Trishan0/cocktail-crafter/frontend/src/assets/backdrops/machine-bg.webp

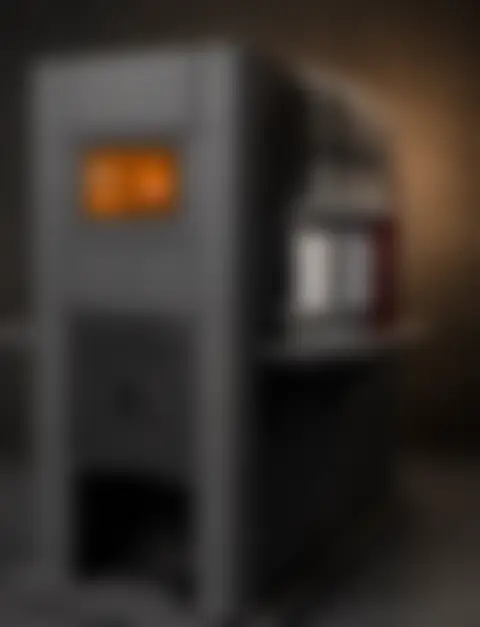
frontend/src/assets/backdrops/machine-bg.webp
