Trishan0/cocktail-crafter/frontend/src/assets/backdrops/machine.webp

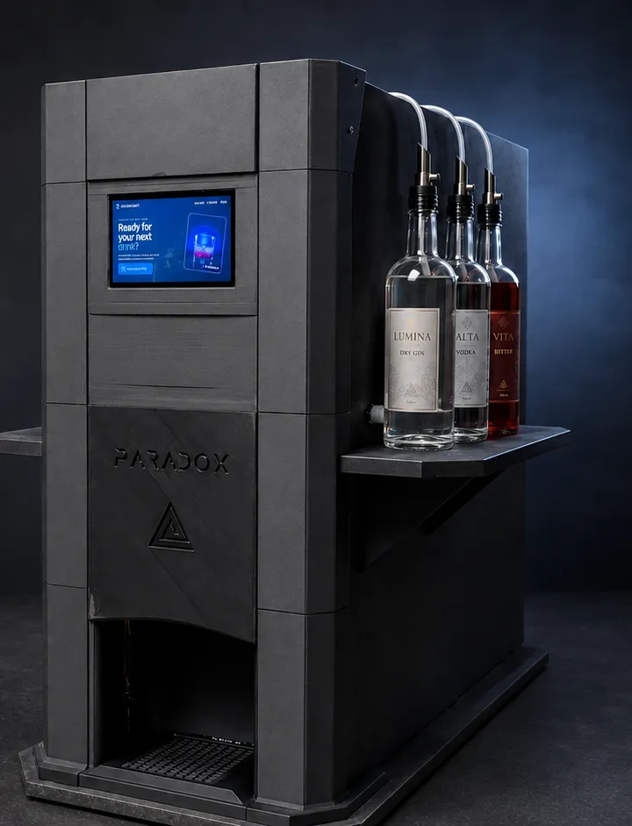
frontend/src/assets/backdrops/machine.webp
