Trishan0/cocktail-crafter/frontend/src/assets/Citriuz rose sprite.png

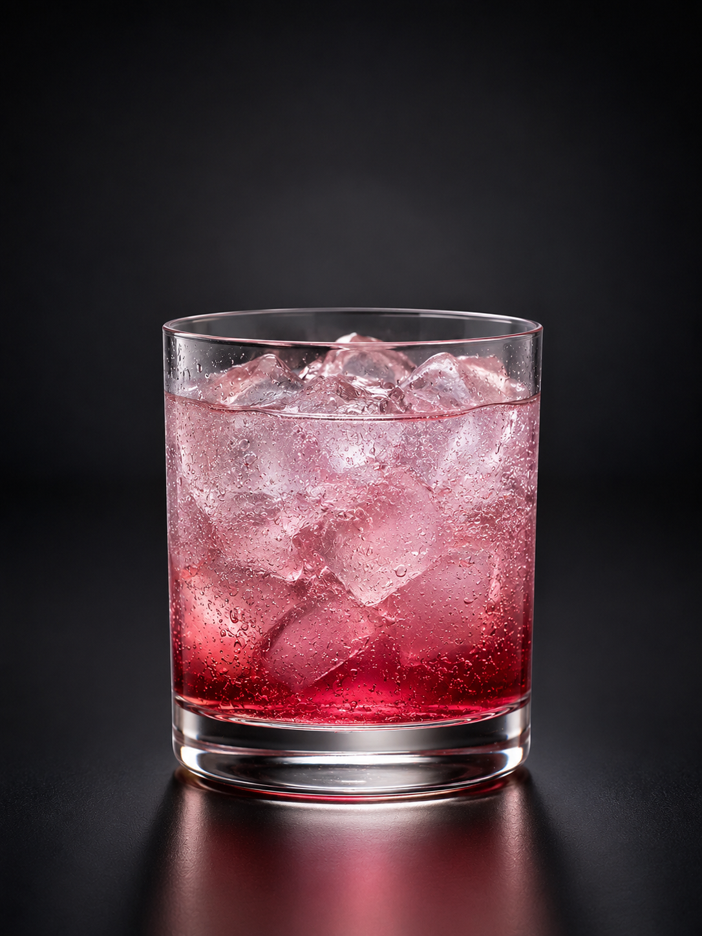
frontend/src/assets/Citriuz rose sprite.png
