Trishan0/cocktail-crafter/frontend/src/assets/cocktail-1.jpg

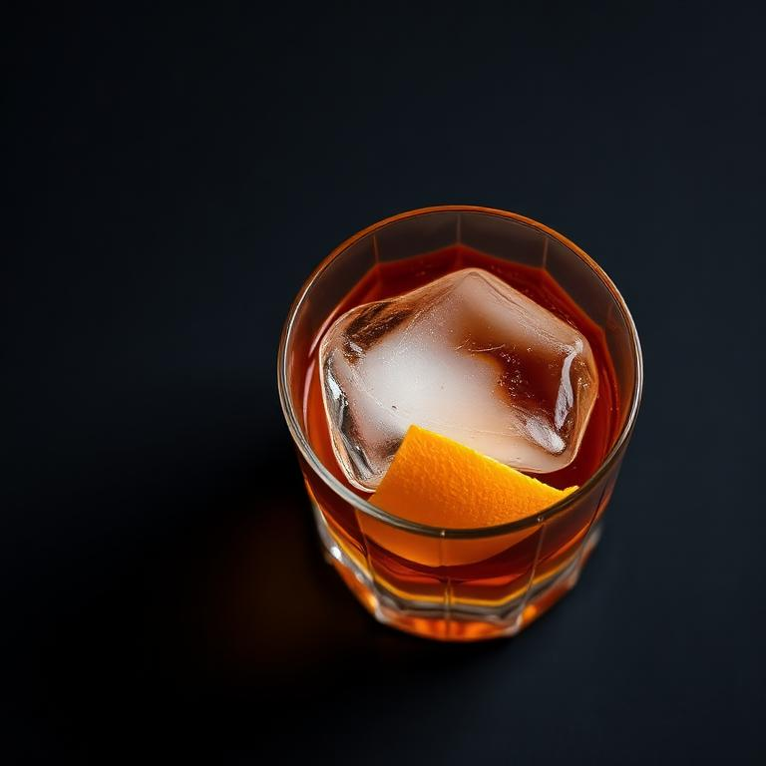
frontend/src/assets/cocktail-1.jpg
