Trishan0/cocktail-crafter/frontend/src/assets/cocktail-2.jpg

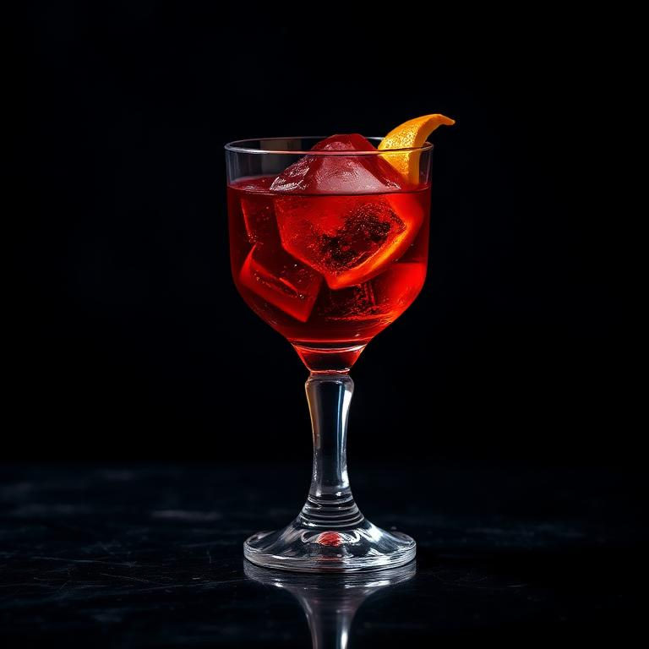
frontend/src/assets/cocktail-2.jpg
