Trishan0/cocktail-crafter/frontend/src/assets/cocktail-3.jpg

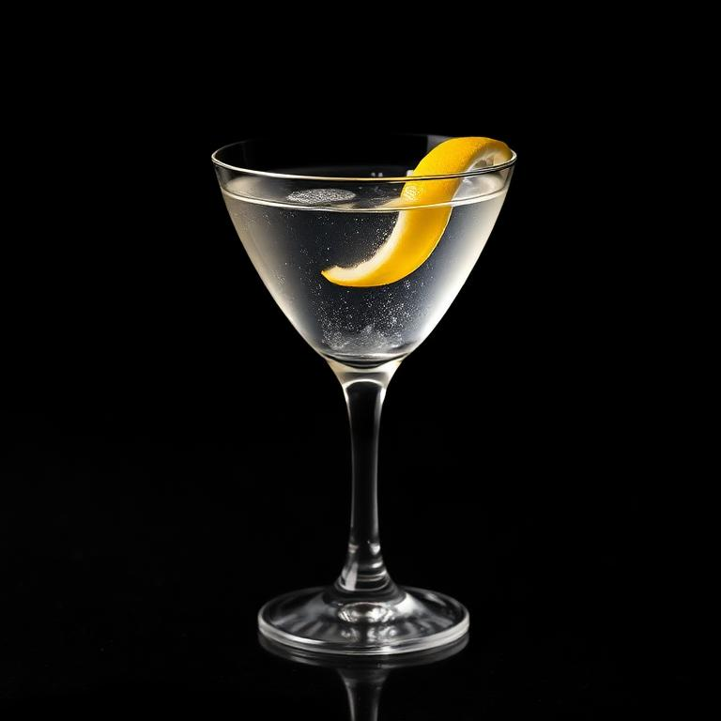
frontend/src/assets/cocktail-3.jpg
