Trishan0/cocktail-crafter/frontend/src/assets/cocktail-4.jpg

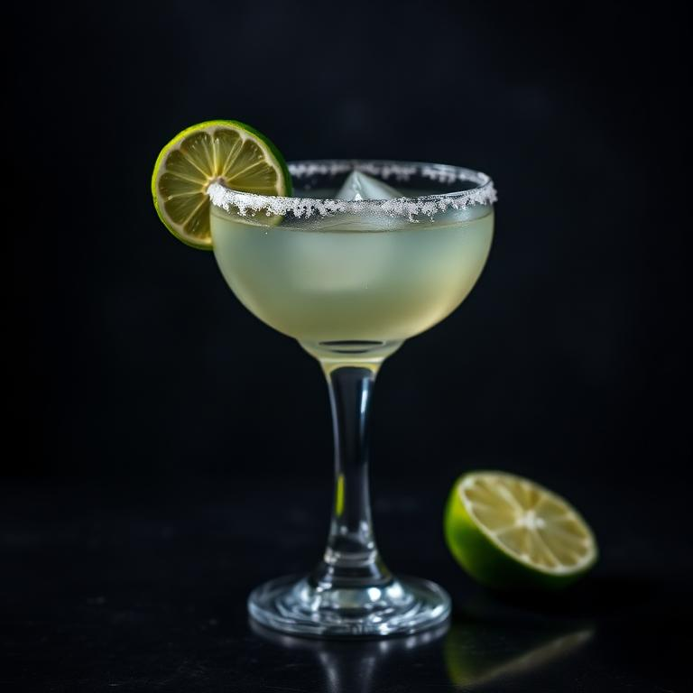
frontend/src/assets/cocktail-4.jpg
