Trishan0/cocktail-crafter/frontend/src/assets/cocktail-5.jpg

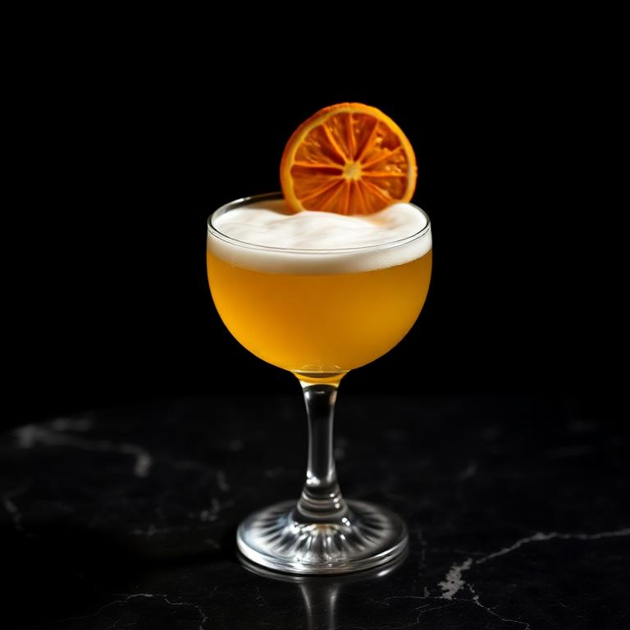
frontend/src/assets/cocktail-5.jpg
