Trishan0/cocktail-crafter/frontend/src/assets/cocktail-6.jpg

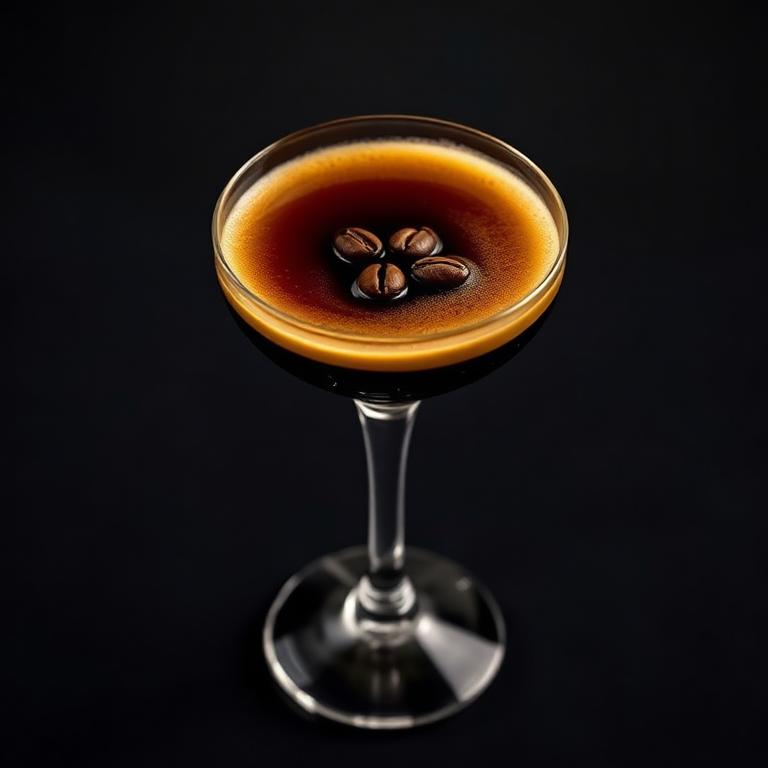
frontend/src/assets/cocktail-6.jpg
