Trishan0/cocktail-crafter/frontend/src/assets/cocktail-ready.png

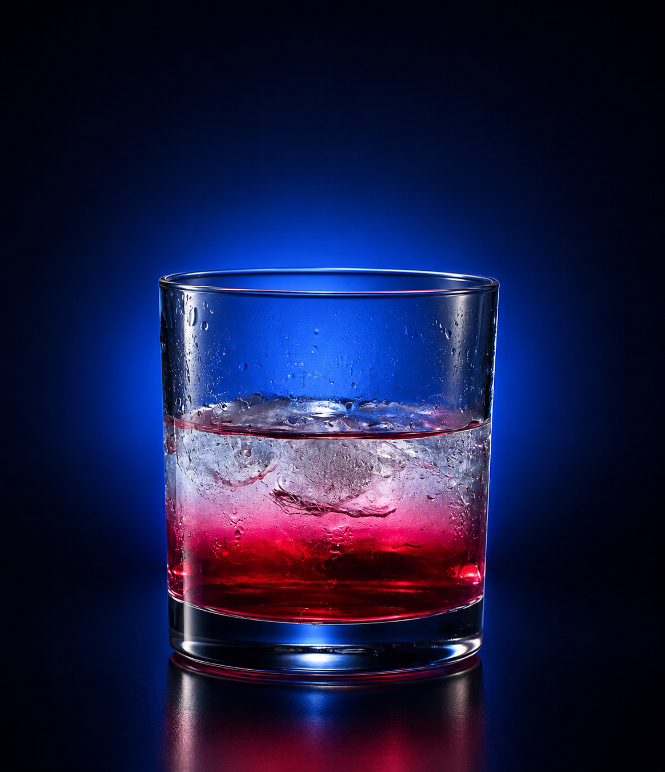
frontend/src/assets/cocktail-ready.png
