Trishan0/cocktail-crafter/frontend/src/assets/custom-drink.png

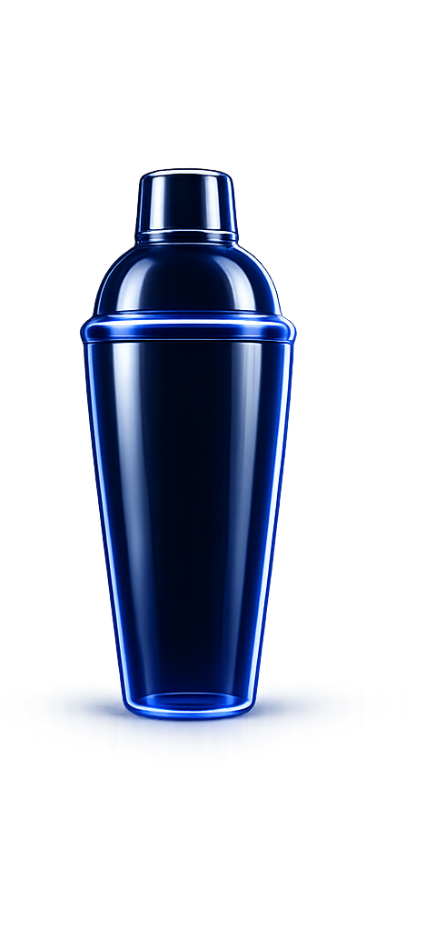
frontend/src/assets/custom-drink.png
