Trishan0/cocktail-crafter/frontend/src/assets/default-drink.png

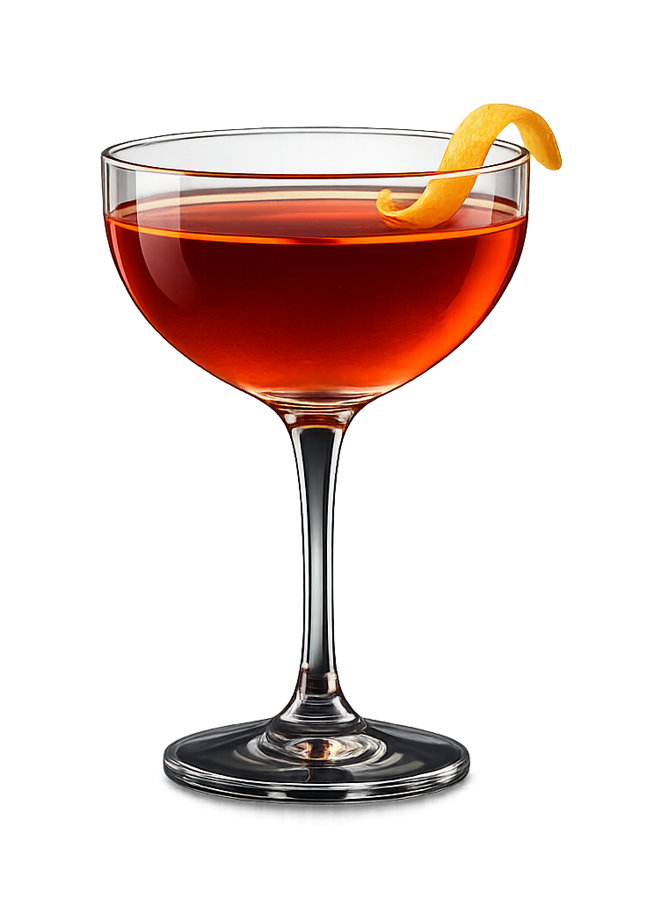
frontend/src/assets/default-drink.png
