Trishan0/cocktail-crafter/frontend/src/assets/drinks/apple-rose-fizz-bg.webp

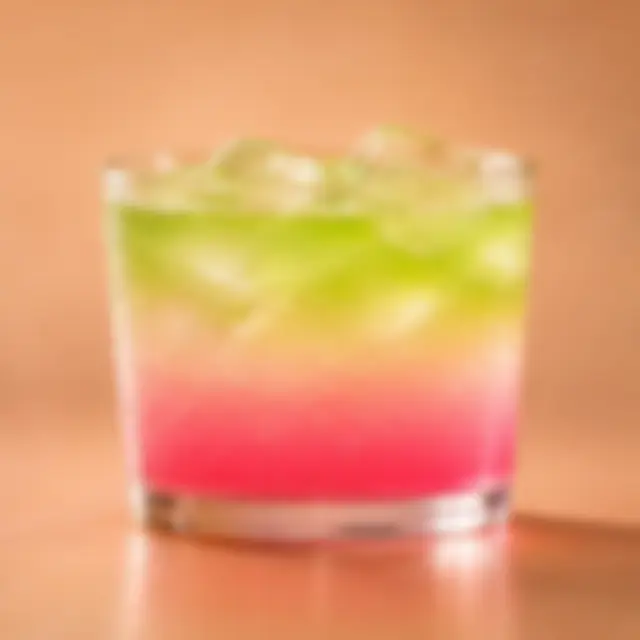
frontend/src/assets/drinks/apple-rose-fizz-bg.webp
