Trishan0/cocktail-crafter/frontend/src/assets/drinks/citrus-sunrise-bg.webp

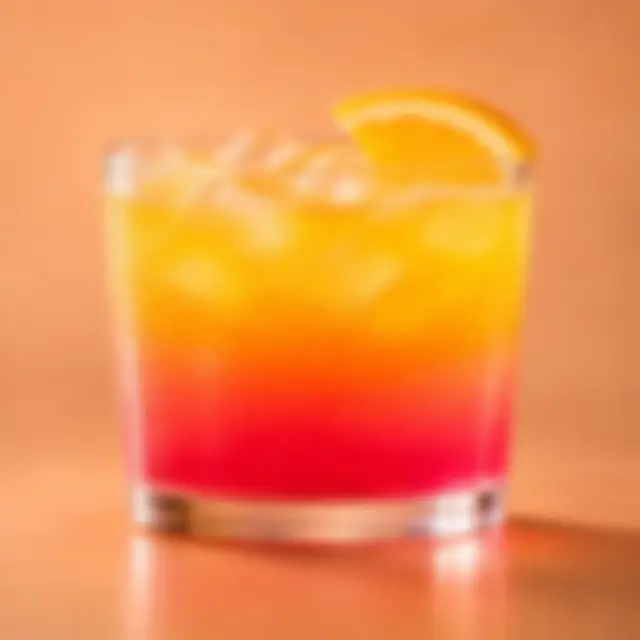
frontend/src/assets/drinks/citrus-sunrise-bg.webp
