Trishan0/cocktail-crafter/frontend/src/assets/drinks/golden-apple-twist-bg.webp

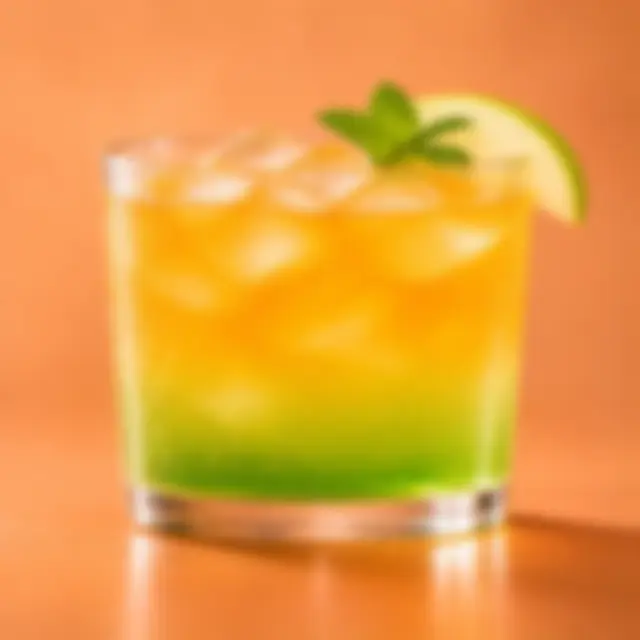
frontend/src/assets/drinks/golden-apple-twist-bg.webp
