Trishan0/cocktail-crafter/frontend/src/assets/drinks/green-apple-sparkle-bg.webp

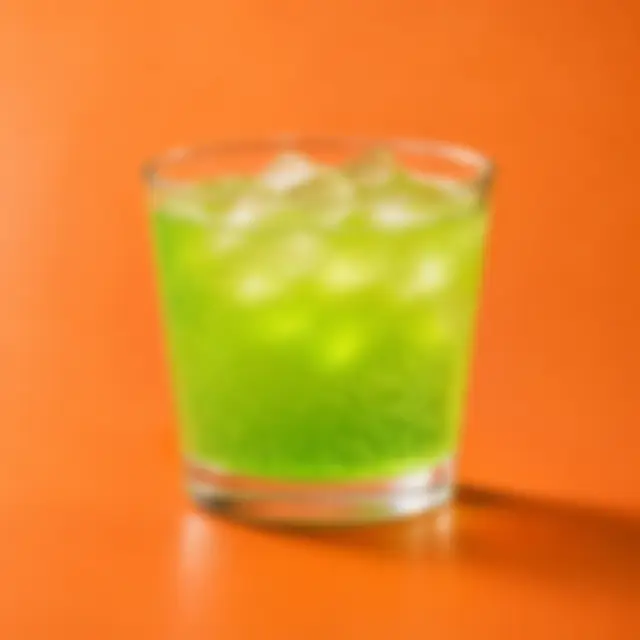
frontend/src/assets/drinks/green-apple-sparkle-bg.webp
