Trishan0/cocktail-crafter/frontend/src/assets/drinks/new/orange_rose_cooler.webp

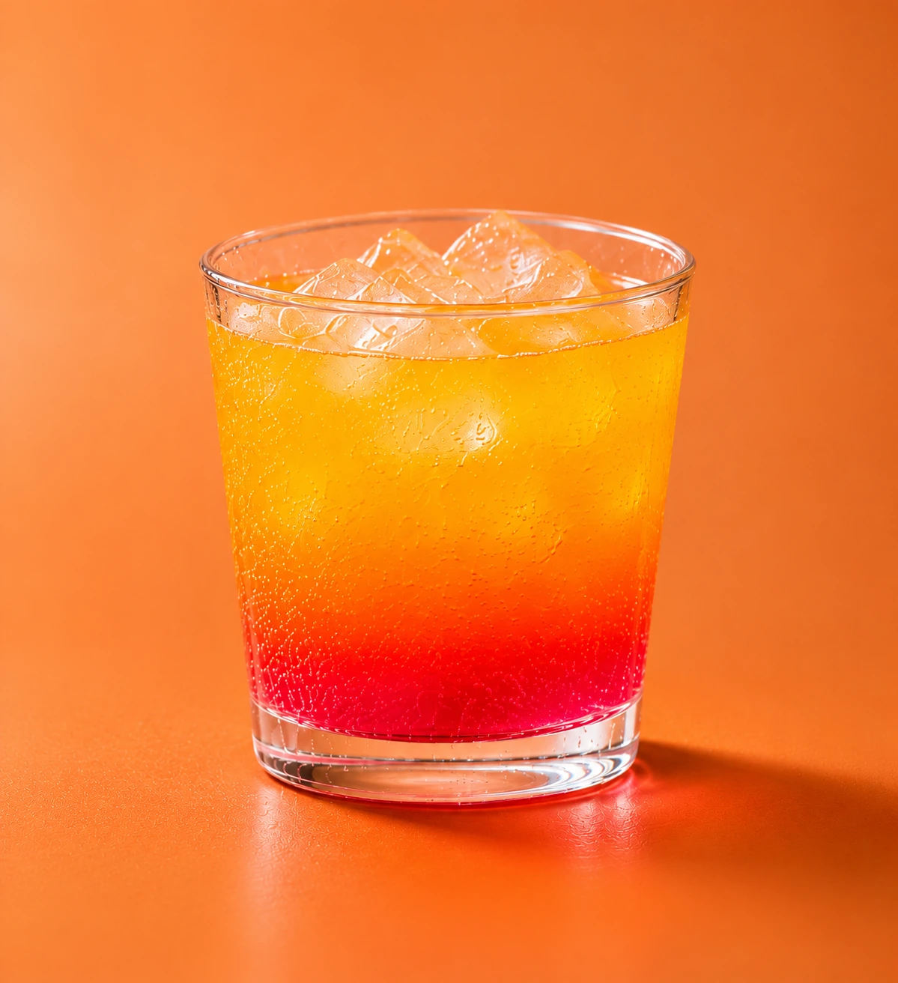
frontend/src/assets/drinks/new/orange_rose_cooler.webp
