Trishan0/cocktail-crafter/frontend/src/assets/drinks/new/pink_apple_sparkle.webp

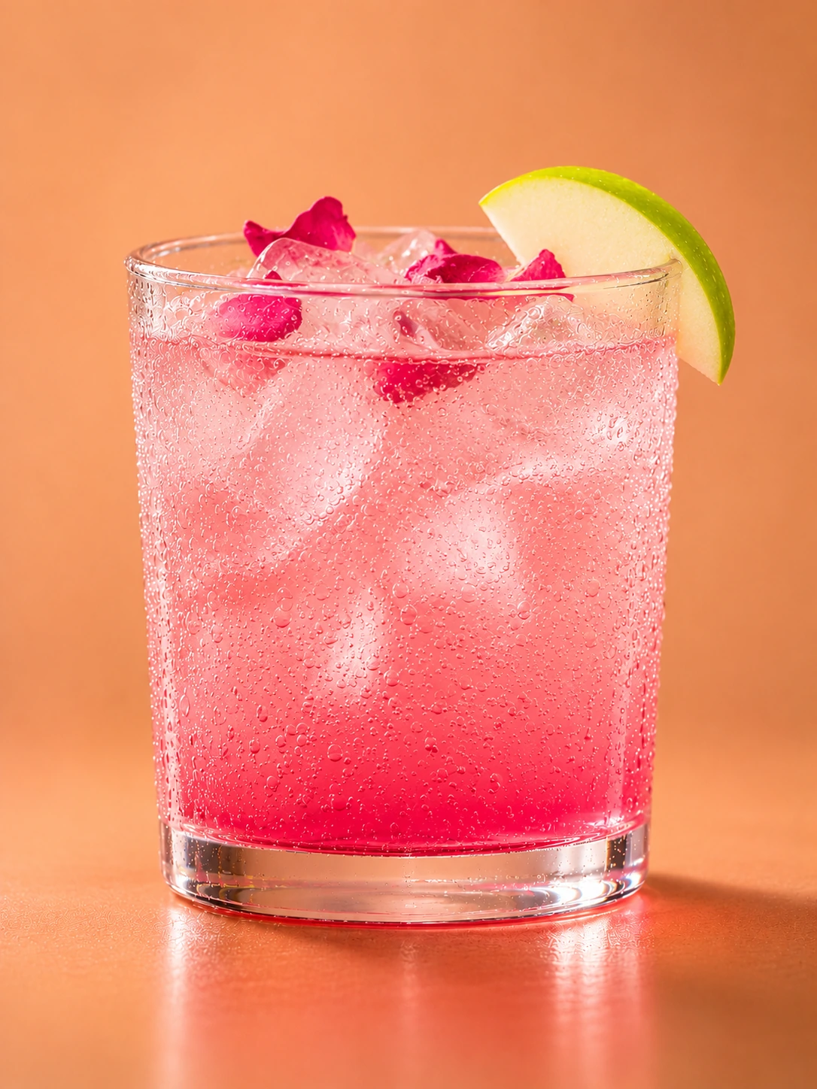
frontend/src/assets/drinks/new/pink_apple_sparkle.webp
