Trishan0/cocktail-crafter/frontend/src/assets/drinks/new/pink_rose_fizz.webp

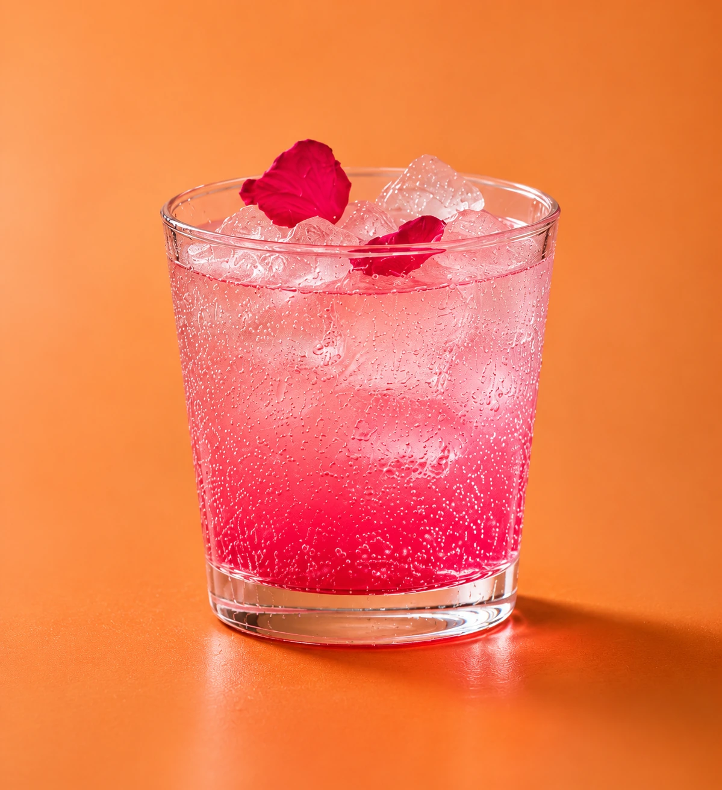
frontend/src/assets/drinks/new/pink_rose_fizz.webp
