Trishan0/cocktail-crafter/frontend/src/assets/drinks/new/royal_rose_cooler.webp

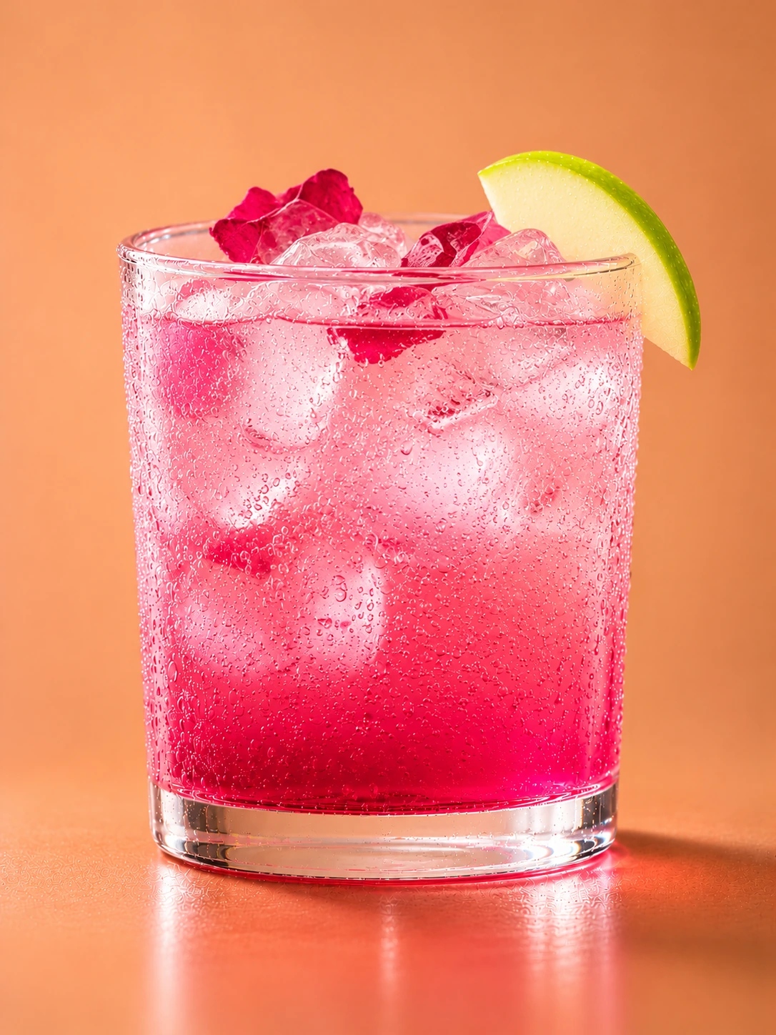
frontend/src/assets/drinks/new/royal_rose_cooler.webp
