Trishan0/cocktail-crafter/frontend/src/assets/drinks/new/strawberry_sprite.webp

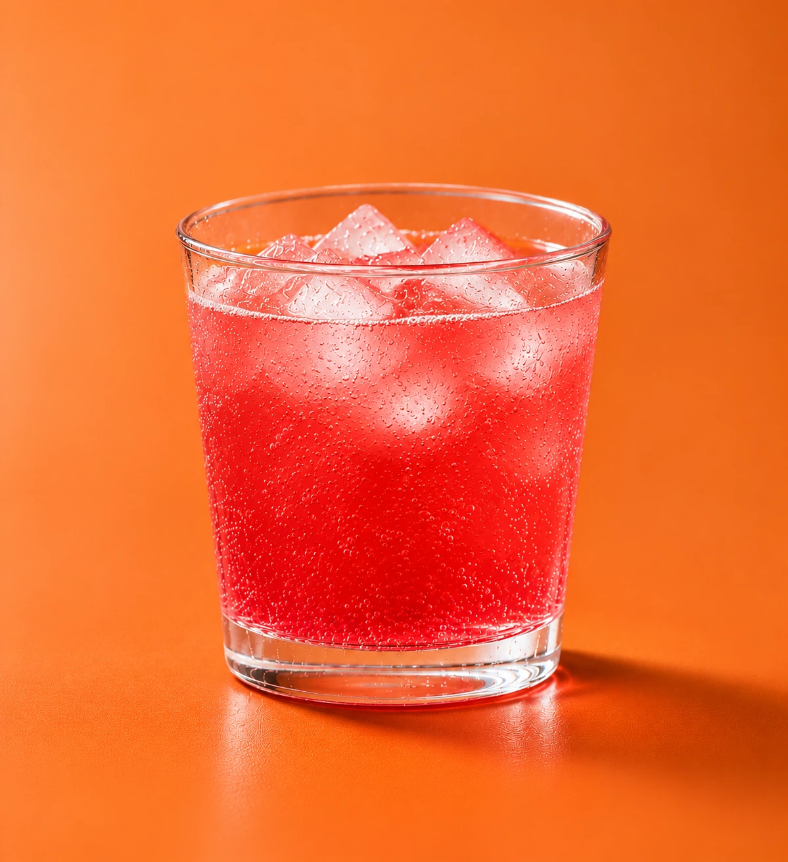
frontend/src/assets/drinks/new/strawberry_sprite.webp
