Trishan0/cocktail-crafter/frontend/src/assets/drinks/new/tropical_sunset.webp

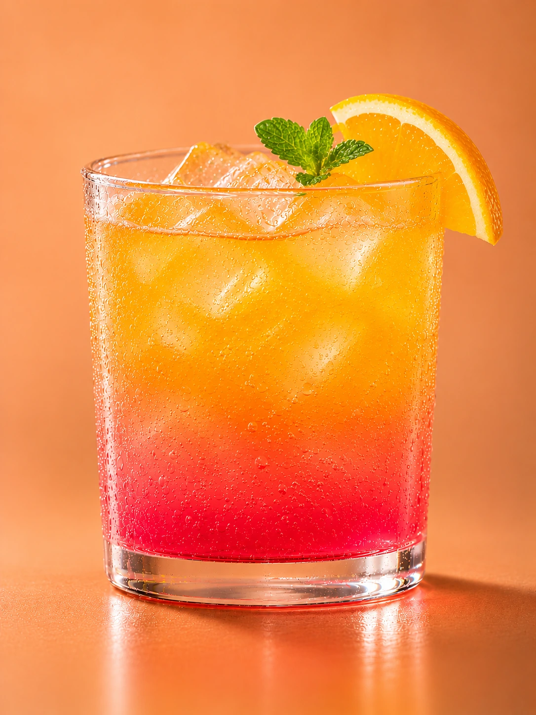
frontend/src/assets/drinks/new/tropical_sunset.webp
