Trishan0/cocktail-crafter/frontend/src/assets/drinks/new/tropical_sunset_drink.webp

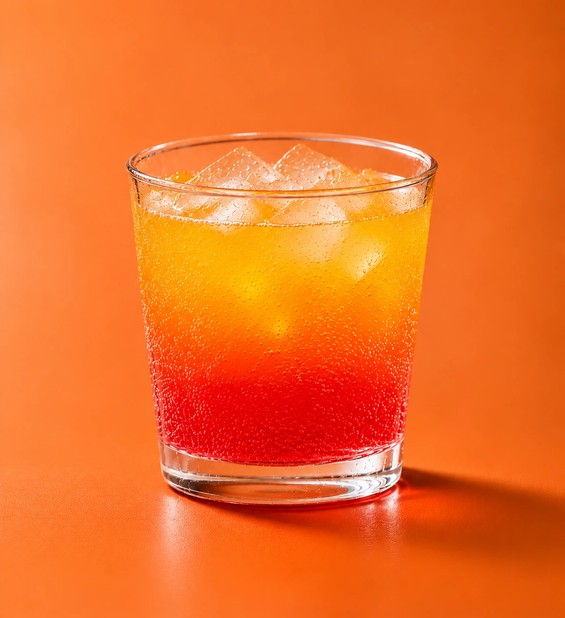
frontend/src/assets/drinks/new/tropical_sunset_drink.webp
