Trishan0/cocktail-crafter/frontend/src/assets/drinks/orange-rose-fizz-bg.webp

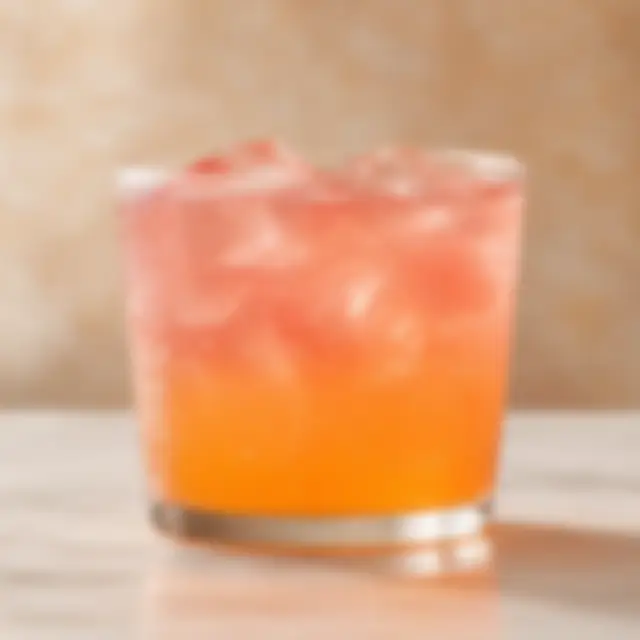
frontend/src/assets/drinks/orange-rose-fizz-bg.webp
