Trishan0/cocktail-crafter/frontend/src/assets/drinks/orange-spritzer-bg.webp

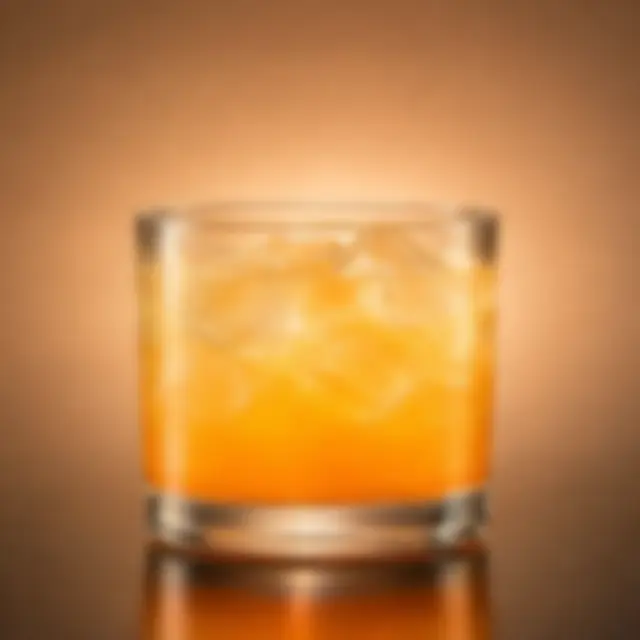
frontend/src/assets/drinks/orange-spritzer-bg.webp
