Trishan0/cocktail-crafter/frontend/src/assets/drinks/rose-lime-fizz-bg.webp

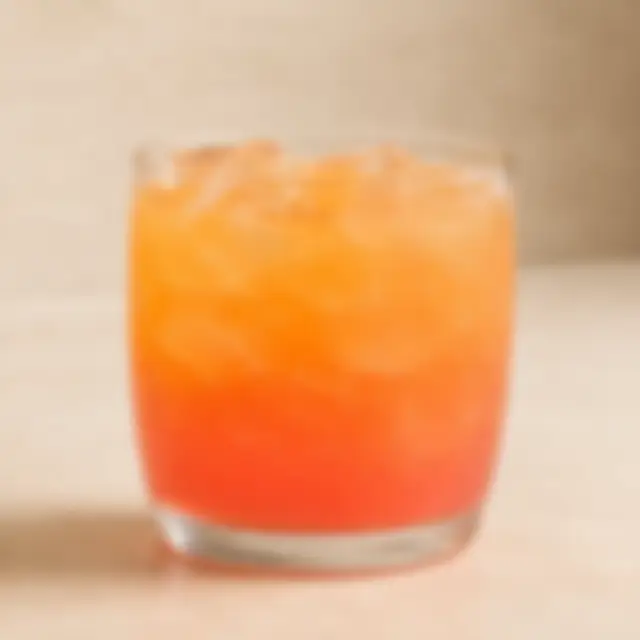
frontend/src/assets/drinks/rose-lime-fizz-bg.webp
