Trishan0/cocktail-crafter/frontend/src/assets/drinks/rose-sprite-bg.webp

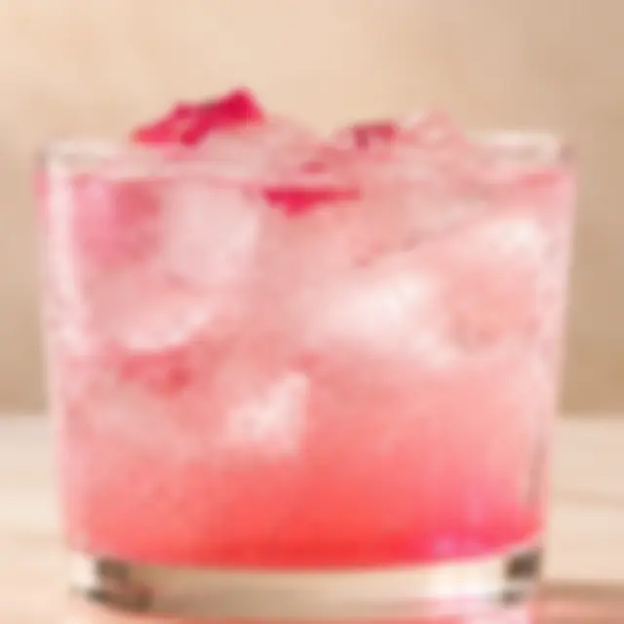
frontend/src/assets/drinks/rose-sprite-bg.webp
