Trishan0/cocktail-crafter/frontend/src/assets/drinks/rose_sprite.webp

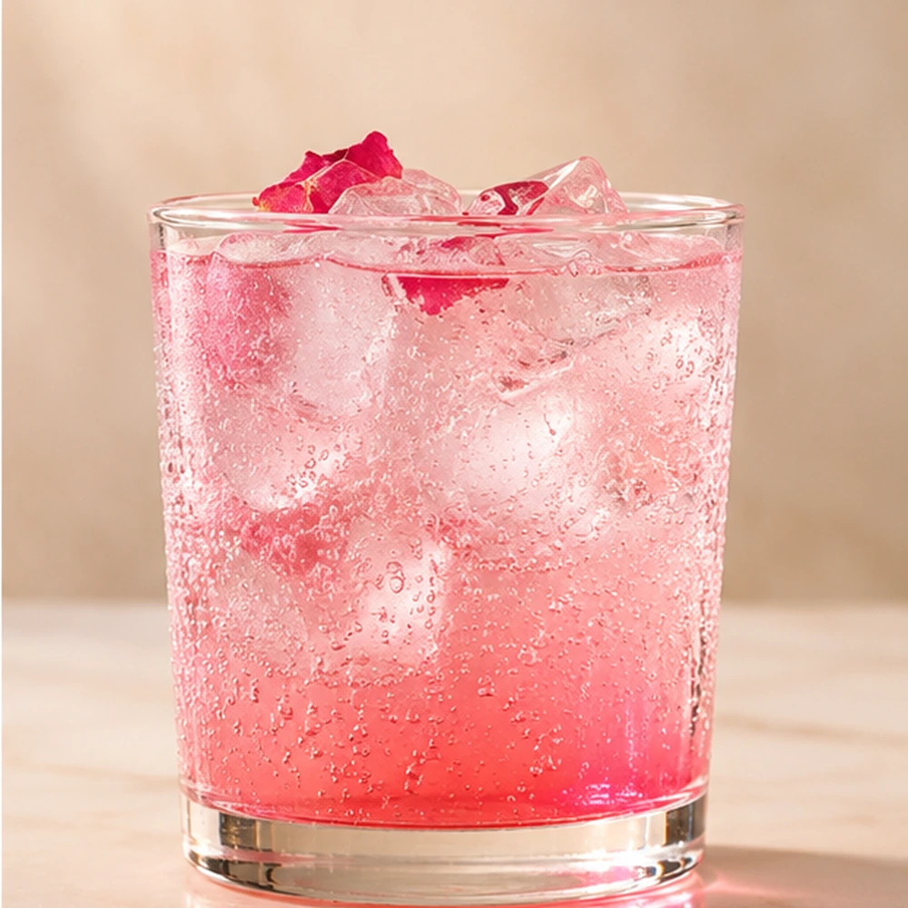
frontend/src/assets/drinks/rose_sprite.webp
