Trishan0/cocktail-crafter/frontend/src/assets/orange-rose-cooler.png

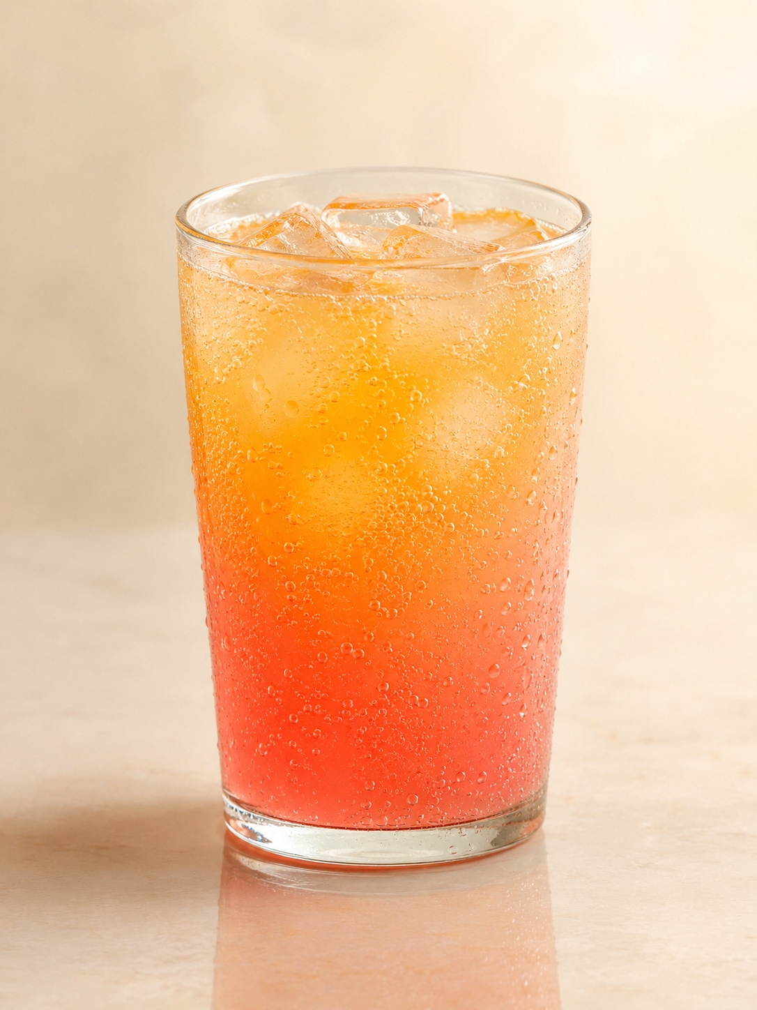
frontend/src/assets/orange-rose-cooler.png
