Trishan0/cocktail-crafter/frontend/src/assets/robot-hero.jpg

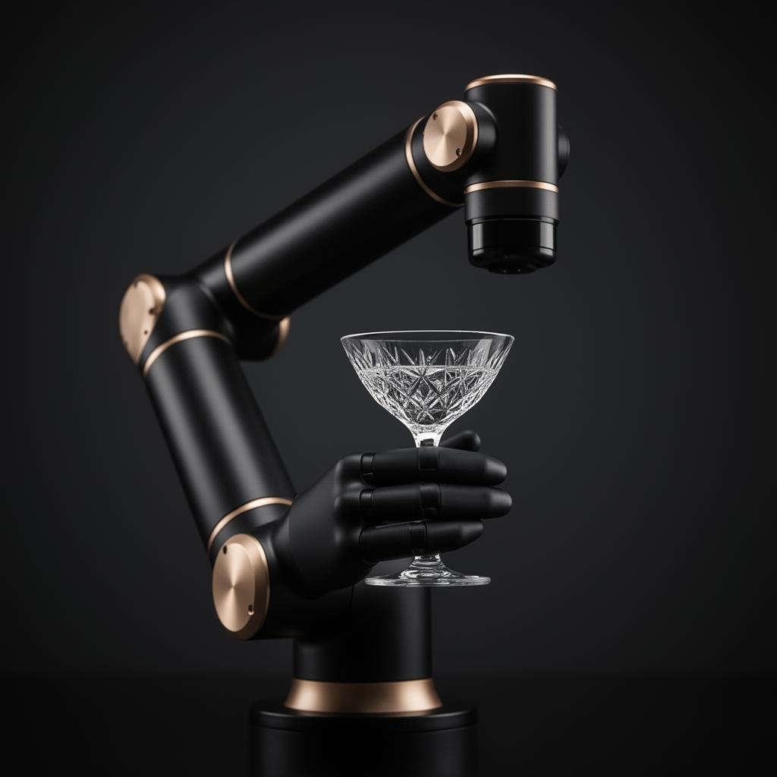
frontend/src/assets/robot-hero.jpg
