Trishan0/cocktail-crafter/frontend/src/assets/drinks/build-your-own-bg.webp

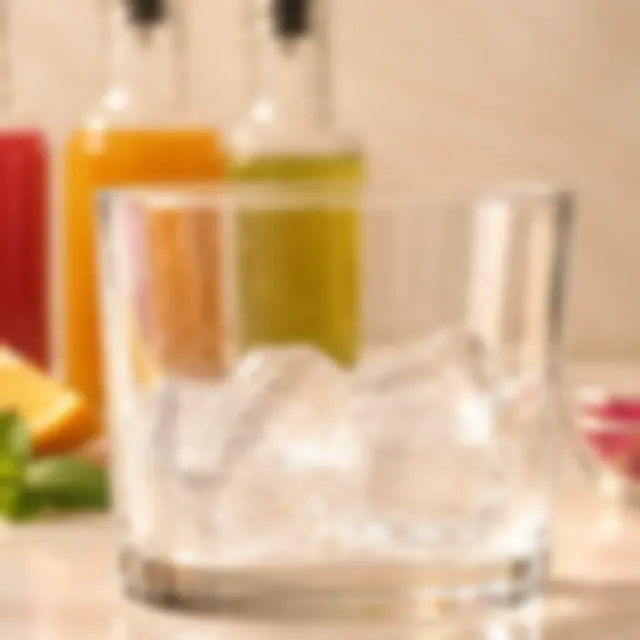
frontend/src/assets/drinks/build-your-own-bg.webp
