Trishan0/cocktail-crafter/frontend/src/assets/drinks/build_your_own_drink.webp

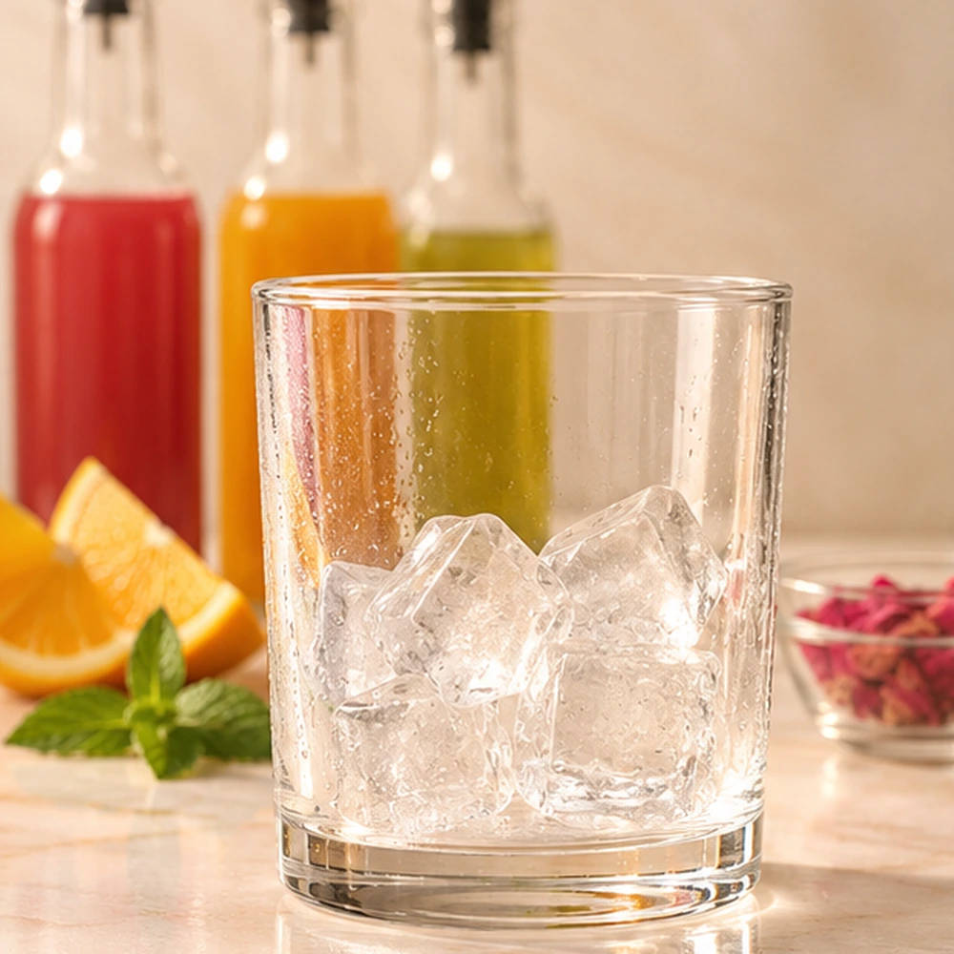
frontend/src/assets/drinks/build_your_own_drink.webp
