Trishan0/cocktail-crafter/backend/config.py

"""
config.py — Centralised Configuration
Cocktail-Craft Bartender | Raspberry Pi
Single source of truth for Serial, Flask, and app settings.
"""

# ─── Serial Connection (ESP32 via USB/UART) ───────────
SIMULATOR_MODE  = False             # If True, bypasses hardware and simulates pouring
SERIAL_PORT     = "/dev/ttyACM0"   # update if ls /dev/tty* shows differently
SERIAL_BAUDRATE = 115200
SERIAL_TIMEOUT  = 1                # seconds read timeout
SERIAL_RECONNECT_SECONDS = 3

# Simulator-only knobs for local UI testing (set by dev_sim.py).
SIMULATOR_DELAY_SCALE = 1.0         # multiply every simulated phase duration
SIMULATOR_AUTO_GLASS  = True        # False: place/remove the glass from the Dev Panel
SIMULATOR_PUMP_TIME_SCALE = 0.1     # simulated pump runs = real duration x this (40 s -> 4 s)

# The current ESP32 firmware rejects an ORDER if a pump time is outside this
# range. Keep the Pi-side validation in lockstep with MAX_PUMP_TIME_MS in the
# firmware.
MAX_PUMP_TIME_MS = 60_000
ORDER_RESPONSE_TIMEOUT_SECONDS = 8
IR_POLL_INTERVAL_SECONDS = 0.75
# After drink/ready, CLEAN is sent only once this many consecutive CHECK_IR
# replies read no-glass (~2 s at the poll interval), so one noisy reading
# while the guest is still reaching for the drink cannot start cleaning.
GLASS_REMOVED_CONFIRMATIONS = 3
LEVEL_RESPONSE_TIMEOUT_SECONDS = 2

# The firmware sends no explicit order-completed event; valve-opened is the
# completion signal. Keep the customer confirmation visible briefly before
# returning the Pi-facing state to idle.
DONE_SCREEN_SECONDS = 5

# ─── Flask ────────────────────────────────────────────
FLASK_PORT  = 5000
FLASK_HOST  = "0.0.0.0"
SECRET_KEY  = "Cocktail-Craft_bartender_secret_2025"

# ─── Pump Hardware ────────────────────────────────────
NUM_PUMPS             = 6
DEFAULT_FLOW_RATE     = 2.5    # ml per second — default for new pumps

# ─── Recipe / Volume Limits ───────────────────────────
MAX_ML_PER_INGREDIENT = 100   # max ml of any single ingredient per drink
MIN_ML_PER_INGREDIENT = 5     # below this, snap to 0 (ignore trace amounts)
MAX_ML_TOTAL          = 300   # max total volume per drink

# An order may use a bottle only when the tracked volume can supply the recipe
# and still leave this reserve. The reserve is not deducted from inventory.
LIQUID_RESERVE_MARGIN_ML = 15

# Default used only when the database has not yet been initialised. Admin
# Hardware settings persist the actual small-glass capacity for this machine.
DEFAULT_SMALL_GLASS_MAX_ML = 170

# ─── Admin ────────────────────────────────────────────
ADMIN_PIN = "1234"             # default PIN, changeable via API
