Trishan0/cocktail-crafter/backend/db.py

"""
db.py — SQLite Database Layer
Cocktail-Craft Bartender | Raspberry Pi

New normalized schema:
  - ingredients     : all known liquids (can grow beyond 10)
  - pumps           : the 6 active hardware slots
  - recipes         : drink definitions
  - recipe_ingredients : junction (recipe ↔ ingredient + amount_ml)
  - orders          : order history with pump command snapshot
"""

import sqlite3
import json
import math
import os
from datetime import datetime
import config

DB_PATH = os.path.join(os.path.dirname(__file__), "Cocktail-Craft.db")


# ─────────────────────────────────────────────
#  CONNECTION
# ─────────────────────────────────────────────

class _ClosingConnection(sqlite3.Connection):
    """Commit/rollback and close when used by the module's ``with`` blocks."""

    def __exit__(self, exc_type, exc_value, traceback):
        try:
            return super().__exit__(exc_type, exc_value, traceback)
        finally:
            self.close()


def get_connection():
    """Return a SQLite connection with row_factory for dict-like access."""
    conn = sqlite3.connect(DB_PATH, factory=_ClosingConnection)
    conn.row_factory = sqlite3.Row
    conn.execute("PRAGMA journal_mode=WAL")
    conn.execute("PRAGMA foreign_keys=ON")
    return conn


# ─────────────────────────────────────────────
#  SCHEMA INIT
# ─────────────────────────────────────────────

def init_db():
    """Create all tables if they don't exist, then seed defaults."""
    with get_connection() as conn:
        conn.executescript("""
            -- All known liquids/ingredients the machine can work with
            CREATE TABLE IF NOT EXISTS ingredients (
                id          INTEGER PRIMARY KEY AUTOINCREMENT,
                name        TEXT    NOT NULL UNIQUE,
                description TEXT    DEFAULT '',
                created_at  TIMESTAMP DEFAULT CURRENT_TIMESTAMP
            );

            -- The 6 active hardware pump slots
            CREATE TABLE IF NOT EXISTS pumps (
                id                  INTEGER PRIMARY KEY AUTOINCREMENT,
                pump_number         INTEGER NOT NULL UNIQUE,  -- 1 to 6
                ingredient_id       INTEGER REFERENCES ingredients(id) ON DELETE SET NULL,
                flow_rate_ml_per_s  REAL    NOT NULL DEFAULT 5,
                current_volume_ml  REAL    NOT NULL DEFAULT 0,
                is_active           INTEGER NOT NULL DEFAULT 1
            );

            -- Drink definitions
            CREATE TABLE IF NOT EXISTS recipes (
                id          INTEGER PRIMARY KEY AUTOINCREMENT,
                name        TEXT    NOT NULL UNIQUE,
                description TEXT    DEFAULT '',
                category    TEXT    NOT NULL DEFAULT 'classic',
                price       REAL    DEFAULT 0.0,
                is_visible  INTEGER NOT NULL DEFAULT 1,
                display_order INTEGER NOT NULL DEFAULT 0,
                created_at  TIMESTAMP DEFAULT CURRENT_TIMESTAMP
            );

            -- Junction table: which ingredient goes in which recipe and how much
            CREATE TABLE IF NOT EXISTS recipe_ingredients (
                id            INTEGER PRIMARY KEY AUTOINCREMENT,
                recipe_id     INTEGER NOT NULL REFERENCES recipes(id) ON DELETE CASCADE,
                ingredient_id INTEGER NOT NULL REFERENCES ingredients(id) ON DELETE CASCADE,
                amount_ml     REAL    NOT NULL,
                UNIQUE(recipe_id, ingredient_id)
            );

            -- Order history
            CREATE TABLE IF NOT EXISTS orders (
                id                   INTEGER PRIMARY KEY AUTOINCREMENT,
                -- An order keeps its recipe name and ingredient snapshot, so
                -- historical records remain meaningful after an Admin deletes
                -- the editable recipe definition.
                recipe_id            INTEGER REFERENCES recipes(id) ON DELETE SET NULL,
                recipe_name          TEXT    NOT NULL,
                status               TEXT    NOT NULL DEFAULT 'pending',
                pump_commands        TEXT,               -- JSON snapshot sent to ESP32
                price                REAL    DEFAULT 0.0,
                ingredients_snapshot TEXT,               -- JSON snapshot of ingredients at order time
                ordered_at           TIMESTAMP DEFAULT CURRENT_TIMESTAMP,
                completed_at         TIMESTAMP
            );

            -- Settings key-value store
            CREATE TABLE IF NOT EXISTS settings (
                key   TEXT PRIMARY KEY,
                value TEXT NOT NULL
            );

            -- Structured event logging
            CREATE TABLE IF NOT EXISTS events (
                id          INTEGER PRIMARY KEY AUTOINCREMENT,
                event_type  TEXT NOT NULL,
                detail      TEXT,
                timestamp   TIMESTAMP DEFAULT CURRENT_TIMESTAMP
            );
        """)
        
        # Add image_url column if it doesn't exist (migration)
        try:
            conn.execute("ALTER TABLE recipes ADD COLUMN image_url TEXT;")
        except sqlite3.OperationalError:
            pass
        try:
            conn.execute("ALTER TABLE recipes ADD COLUMN display_order INTEGER NOT NULL DEFAULT 0;")
        except sqlite3.OperationalError:
            pass
        # Existing recipes receive a stable initial menu order. New recipes
        # are appended and Admin can subsequently move any recipe up/down.
        conn.execute("UPDATE recipes SET display_order = id WHERE display_order <= 0")

        # Add order columns if they do not exist
        try:
            conn.execute("ALTER TABLE orders ADD COLUMN price REAL DEFAULT 0.0;")
        except sqlite3.OperationalError:
            pass
        try:
            conn.execute("ALTER TABLE orders ADD COLUMN ingredients_snapshot TEXT;")
        except sqlite3.OperationalError:
            pass
        # Keep current inventory for existing databases. Legacy per-pump
        # baseline/polarity columns from an earlier implementation are ignored:
        # the installed hardware has one shared physical sensor height.
        for column, definition in (
            ("current_volume_ml", "REAL NOT NULL DEFAULT 0"),
        ):
            try:
                conn.execute(f"ALTER TABLE pumps ADD COLUMN {column} {definition};")
            except sqlite3.OperationalError:
                pass
            
    _seed_defaults()
    print("[DB] Database initialized.")


# ─────────────────────────────────────────────
#  SEED DEFAULTS
# ─────────────────────────────────────────────

DEFAULT_INGREDIENTS = [
    "Water", "Rum", "Vodka", "Gin", "Tequila", "Whiskey",
    "Triple Sec", "Blue Curaçao", "Campari",
    "Lime Juice", "Lemon Juice", "Simple Syrup",
    "Grenadine", "Coconut Cream", "Orange Juice",
    "Cranberry Juice", "Pineapple Juice", "Cola",
]

DEFAULT_PUMP_ASSIGNMENTS = {
    1: "Water",
    2: "Vodka",
    3: "Gin",
    4: "Lime Juice",
    5: "Simple Syrup",
    6: "Orange Juice",
}

DEFAULT_RECIPES = [
    {
        "name": "Mojito",
        "category": "classic",
        "description": "Fresh mint, lime & rum",
        "price": 12.0,
        "ingredients": {"Rum": 50, "Lime Juice": 25, "Simple Syrup": 15},
    },
    {
        "name": "Gin & Tonic",
        "category": "classic",
        "description": "Crisp gin with tonic water",
        "price": 10.0,
        "ingredients": {"Gin": 50, "Lime Juice": 10},
    },
    {
        "name": "Tequila Sunrise",
        "category": "classic",
        "description": "Tequila, orange juice & grenadine",
        "price": 11.0,
        "ingredients": {"Tequila": 45, "Orange Juice": 90, "Grenadine": 15},
    },
    {
        "name": "Vodka Lime",
        "category": "signature",
        "description": "Vodka with fresh lime juice",
        "price": 9.0,
        "ingredients": {"Vodka": 50, "Lime Juice": 20, "Simple Syrup": 10},
    },
]


def _seed_defaults():
    """Seed ingredients, pumps, and recipes only if tables are empty."""
    with get_connection() as conn:
        # Added after initial releases: existing databases need Water as well,
        # not only newly seeded ones.
        conn.execute("INSERT OR IGNORE INTO ingredients (name) VALUES ('Water')")
        # Seed ingredients
        ing_count = conn.execute("SELECT COUNT(*) FROM ingredients").fetchone()[0]
        if ing_count == 0:
            for name in DEFAULT_INGREDIENTS:
                conn.execute("INSERT OR IGNORE INTO ingredients (name) VALUES (?)", (name,))
            print(f"[DB] Seeded {len(DEFAULT_INGREDIENTS)} default ingredients.")

        # Seed pump slots 1-6
        pump_count = conn.execute("SELECT COUNT(*) FROM pumps").fetchone()[0]
        if pump_count == 0:
            for pnum in range(1, config.NUM_PUMPS + 1):
                ing_name = DEFAULT_PUMP_ASSIGNMENTS.get(pnum)
                ing_id = None
                if ing_name:
                    row = conn.execute(
                        "SELECT id FROM ingredients WHERE name = ?", (ing_name,)
                    ).fetchone()
                    if row:
                        ing_id = row["id"]
                conn.execute(
                    """INSERT INTO pumps (pump_number, ingredient_id, flow_rate_ml_per_s)
                       VALUES (?, ?, ?)""",
                    (pnum, ing_id, config.DEFAULT_FLOW_RATE)
                )
            print(f"[DB] Seeded {config.NUM_PUMPS} pump slots.")

        # Seed recipes
        recipe_count = conn.execute("SELECT COUNT(*) FROM recipes").fetchone()[0]
        if recipe_count == 0:
            for position, r in enumerate(DEFAULT_RECIPES, start=1):
                cursor = conn.execute(
                    """INSERT INTO recipes (name, description, category, price, display_order)
                       VALUES (?, ?, ?, ?, ?)""",
                    (r["name"], r["description"], r["category"], r["price"], position)
                )
                recipe_id = cursor.lastrowid
                for ing_name, amount_ml in r["ingredients"].items():
                    row = conn.execute(
                        "SELECT id FROM ingredients WHERE name = ?", (ing_name,)
                    ).fetchone()
                    if row:
                        conn.execute(
                            """INSERT INTO recipe_ingredients (recipe_id, ingredient_id, amount_ml)
                               VALUES (?, ?, ?)""",
                            (recipe_id, row["id"], amount_ml)
                        )
            print(f"[DB] Seeded {len(DEFAULT_RECIPES)} default recipes.")


# ─────────────────────────────────────────────
#  INGREDIENTS
# ─────────────────────────────────────────────

def get_all_ingredients():
    """Return all ingredients as list of dicts."""
    with get_connection() as conn:
        rows = conn.execute(
            "SELECT * FROM ingredients ORDER BY name"
        ).fetchall()
    return [dict(r) for r in rows]


def get_ingredients_by_ids(ingredient_ids: list[int]):
    """Return an ID-to-ingredient mapping for server-side custom-order input."""
    unique_ids = sorted(set(ingredient_ids))
    if not unique_ids:
        return {}
    placeholders = ",".join("?" for _ in unique_ids)
    with get_connection() as conn:
        rows = conn.execute(
            f"SELECT id, name FROM ingredients WHERE id IN ({placeholders})",
            unique_ids,
        ).fetchall()
    return {row["id"]: dict(row) for row in rows}


def create_ingredient(name: str, description: str = ""):
    """Insert a new ingredient. Returns new id or raises if name exists."""
    name = name.strip()
    with get_connection() as conn:
        cursor = conn.execute(
            "INSERT INTO ingredients (name, description) VALUES (?, ?)",
            (name, description)
        )
        return cursor.lastrowid


def update_ingredient(ingredient_id: int, name: str = None, description: str = None):
    with get_connection() as conn:
        if name is not None:
            conn.execute(
                "UPDATE ingredients SET name = ? WHERE id = ?", (name.strip(), ingredient_id)
            )
        if description is not None:
            conn.execute(
                "UPDATE ingredients SET description = ? WHERE id = ?", (description, ingredient_id)
            )


def delete_ingredient(ingredient_id: int):
    """Delete ingredient (cascade will remove recipe_ingredient rows too)."""
    with get_connection() as conn:
        conn.execute("DELETE FROM ingredients WHERE id = ?", (ingredient_id,))


# ─────────────────────────────────────────────
#  PUMPS
# ─────────────────────────────────────────────

def get_all_pumps():
    """
    Return all 6 pump slots with their assigned ingredient info.
    """
    with get_connection() as conn:
        rows = conn.execute("""
            SELECT p.id, p.pump_number, p.flow_rate_ml_per_s,
                   p.current_volume_ml, p.is_active,
                   i.id   AS ingredient_id,
                   i.name AS ingredient_name
            FROM pumps p
            LEFT JOIN ingredients i ON p.ingredient_id = i.id
            ORDER BY p.pump_number
        """).fetchall()
    return [dict(r) for r in rows]


def assign_pump(pump_number: int, ingredient_id: int = None):
    """Assign (or unassign) an ingredient to a pump slot."""
    with get_connection() as conn:
        if pump_number == 1:
            ingredient = conn.execute(
                "SELECT name FROM ingredients WHERE id = ?", (ingredient_id,)
            ).fetchone()
            if not ingredient or ingredient["name"].strip().lower() != "water":
                raise ValueError("Pump 1 is reserved for Water.")
        conn.execute(
            "UPDATE pumps SET ingredient_id = ? WHERE pump_number = ?",
            (ingredient_id, pump_number)
        )


def update_pump_flow_rate(pump_number: int, flow_rate: float):
    """Update the calibrated flow rate for a pump."""
    with get_connection() as conn:
        conn.execute(
            "UPDATE pumps SET flow_rate_ml_per_s = ? WHERE pump_number = ?",
            (flow_rate, pump_number)
        )


def update_pump_inventory(pump_number: int, current_volume_ml: float):
    """Store the admin-maintained volume estimate for one bottle."""
    with get_connection() as conn:
        conn.execute(
            "UPDATE pumps SET current_volume_ml = ? WHERE pump_number = ?",
            (current_volume_ml, pump_number),
        )


def reserve_pump_inventory(pump_commands: list, reserve_margin_ml: float) -> list[dict]:
    """Atomically check and deduct one order from tracked bottle volumes.

    Only the ordered amount is deducted. ``reserve_margin_ml`` must remain in
    every used bottle after the deduction. A non-empty return value describes
    shortages; in that case no bottle is changed.
    """
    margin = float(reserve_margin_ml)
    if not math.isfinite(margin) or margin < 0:
        raise ValueError("reserve_margin_ml must be a non-negative finite number.")

    requested_by_pump: dict[int, float] = {}
    for command in pump_commands:
        pump_number = int(command["pump"])
        amount_ml = float(command["amount_ml"])
        if not math.isfinite(amount_ml) or amount_ml <= 0:
            raise ValueError(f"Pump {pump_number} needs a positive finite order amount.")
        requested_by_pump[pump_number] = requested_by_pump.get(pump_number, 0.0) + amount_ml

    with get_connection() as conn:
        # Prevent two simultaneous HTTP requests from both spending the same
        # tracked volume between the check and the update.
        conn.execute("BEGIN IMMEDIATE")
        shortages = []
        for pump_number, amount_ml in sorted(requested_by_pump.items()):
            row = conn.execute(
                """SELECT p.current_volume_ml, i.name AS ingredient_name
                   FROM pumps p
                   LEFT JOIN ingredients i ON p.ingredient_id = i.id
                   WHERE p.pump_number = ?""",
                (pump_number,),
            ).fetchone()
            if not row:
                shortages.append({
                    "pump": pump_number,
                    "ingredient": f"Pump {pump_number}",
                    "current_ml": 0.0,
                    "required_ml": amount_ml,
                    "minimum_ml": amount_ml + margin,
                })
                continue

            current_ml = float(row["current_volume_ml"] or 0)
            minimum_ml = amount_ml + margin
            if current_ml < minimum_ml:
                shortages.append({
                    "pump": pump_number,
                    "ingredient": row["ingredient_name"] or f"Pump {pump_number}",
                    "current_ml": current_ml,
                    "required_ml": amount_ml,
                    "minimum_ml": minimum_ml,
                })

        if shortages:
            return shortages

        for pump_number, amount_ml in requested_by_pump.items():
            conn.execute(
                """UPDATE pumps
                   SET current_volume_ml = current_volume_ml - ?
                   WHERE pump_number = ?""",
                (amount_ml, pump_number),
            )
    return []


def restore_pump_inventory(pump_commands: list):
    """Undo a reservation when an order could not be sent to the ESP32."""
    with get_connection() as conn:
        for command in pump_commands:
            conn.execute(
                """UPDATE pumps
                   SET current_volume_ml = current_volume_ml + ?
                   WHERE pump_number = ?""",
                (float(command["amount_ml"]), int(command["pump"])),
            )


def get_pump_assignments():
    """
    Return active assignments keyed by ingredient_id.
    Used by recipe_manager to resolve ingredients to pumps.
    """
    pumps = get_all_pumps()
    mapping = {}
    for p in pumps:
        if p["ingredient_id"] is not None and bool(p["is_active"]):
            mapping[p["ingredient_id"]] = {
                "pump_number":       p["pump_number"],
                "flow_rate_ml_per_s": p["flow_rate_ml_per_s"],
                "current_volume_ml": p["current_volume_ml"],
                "ingredient_name": p["ingredient_name"],
                "is_active": p["is_active"],
            }
    return mapping

# ─────────────────────────────────────────────
#  RECIPES
# ─────────────────────────────────────────────

def get_all_recipes(visible_only=True):
    """Return recipes with their ingredient lists."""
    with get_connection() as conn:
        if visible_only:
            rows = conn.execute(
                "SELECT * FROM recipes WHERE is_visible = 1 ORDER BY display_order, id"
            ).fetchall()
        else:
            rows = conn.execute(
                "SELECT * FROM recipes ORDER BY display_order, id"
            ).fetchall()

        result = []
        for row in rows:
            r = dict(row)
            ings = conn.execute("""
                SELECT i.id, i.name, ri.amount_ml
                FROM recipe_ingredients ri
                JOIN ingredients i ON ri.ingredient_id = i.id
                WHERE ri.recipe_id = ?
            """, (r["id"],)).fetchall()
            r["ingredients"] = [dict(ing) for ing in ings]
            result.append(r)
    return result


def get_recipe_by_id(recipe_id: int):
    with get_connection() as conn:
        row = conn.execute(
            "SELECT * FROM recipes WHERE id = ?", (recipe_id,)
        ).fetchone()
        if not row:
            return None
        r = dict(row)
        ings = conn.execute("""
            SELECT i.id, i.name, ri.amount_ml
            FROM recipe_ingredients ri
            JOIN ingredients i ON ri.ingredient_id = i.id
            WHERE ri.recipe_id = ?
        """, (recipe_id,)).fetchall()
        r["ingredients"] = [dict(ing) for ing in ings]
    return r


def create_recipe(name: str, description: str, category: str, price: float, ingredients: list, image_url: str = None):
    """
    Create a recipe with ingredients.
    ingredients: [{"ingredient_id": 1, "amount_ml": 50}, ...]
    Returns new recipe_id.
    """
    with get_connection() as conn:
        next_display_order = conn.execute(
            "SELECT COALESCE(MAX(display_order), 0) + 1 FROM recipes"
        ).fetchone()[0]
        cursor = conn.execute(
            """INSERT INTO recipes (name, description, category, price, image_url, display_order)
               VALUES (?, ?, ?, ?, ?, ?)""",
            (name.strip(), description, category, price, image_url, next_display_order)
        )
        recipe_id = cursor.lastrowid
        for ing in ingredients:
            conn.execute(
                "INSERT INTO recipe_ingredients (recipe_id, ingredient_id, amount_ml) VALUES (?, ?, ?)",
                (recipe_id, ing["ingredient_id"], ing["amount_ml"])
            )
    return recipe_id


def update_recipe(recipe_id: int, name: str = None, description: str = None,
                  category: str = None, price: float = None,
                  is_visible: int = None, ingredients: list = None, image_url: str = None):
    with get_connection() as conn:
        if name is not None:
            conn.execute("UPDATE recipes SET name = ? WHERE id = ?", (name.strip(), recipe_id))
        if description is not None:
            conn.execute("UPDATE recipes SET description = ? WHERE id = ?", (description, recipe_id))
        if category is not None:
            conn.execute("UPDATE recipes SET category = ? WHERE id = ?", (category, recipe_id))
        if price is not None:
            conn.execute("UPDATE recipes SET price = ? WHERE id = ?", (price, recipe_id))
        if is_visible is not None:
            conn.execute("UPDATE recipes SET is_visible = ? WHERE id = ?", (is_visible, recipe_id))
        if image_url is not None:
            conn.execute("UPDATE recipes SET image_url = ? WHERE id = ?", (image_url, recipe_id))
        if ingredients is not None:
            conn.execute("DELETE FROM recipe_ingredients WHERE recipe_id = ?", (recipe_id,))
            for ing in ingredients:
                conn.execute(
                    "INSERT INTO recipe_ingredients (recipe_id, ingredient_id, amount_ml) VALUES (?, ?, ?)",
                    (recipe_id, ing["ingredient_id"], ing["amount_ml"])
                )


def delete_recipe(recipe_id: int) -> bool:
    """Delete a recipe without deleting its immutable order history.

    Existing deployed databases created before ``ON DELETE SET NULL`` was
    added use SQLite's restrictive default foreign key.  Null the optional
    ``orders.recipe_id`` explicitly first so both old and new database files
    preserve historical order snapshots while allowing Admin to remove a
    recipe.
    """
    with get_connection() as conn:
        conn.execute("UPDATE orders SET recipe_id = NULL WHERE recipe_id = ?", (recipe_id,))
        cursor = conn.execute("DELETE FROM recipes WHERE id = ?", (recipe_id,))
    return cursor.rowcount > 0


def set_recipe_display_order(recipe_ids: list[int]):
    """Persist a complete, explicit admin-selected recipe menu order."""
    normalised_ids = [int(recipe_id) for recipe_id in recipe_ids]
    if len(normalised_ids) != len(set(normalised_ids)):
        raise ValueError("Recipe order cannot contain duplicate recipes.")

    with get_connection() as conn:
        existing_ids = {
            int(row["id"])
            for row in conn.execute("SELECT id FROM recipes").fetchall()
        }
        if set(normalised_ids) != existing_ids:
            raise ValueError("Recipe order must include every current recipe exactly once.")
        for position, recipe_id in enumerate(normalised_ids, start=1):
            conn.execute(
                "UPDATE recipes SET display_order = ? WHERE id = ?",
                (position, recipe_id),
            )


# ─────────────────────────────────────────────
#  ORDERS
# ─────────────────────────────────────────────

def create_order(recipe_id: int, recipe_name: str, pump_commands: list, price: float = 0.0, ingredients_snapshot: list = None):
    """Insert a new order and return its id."""
    with get_connection() as conn:
        cursor = conn.execute(
            """INSERT INTO orders (recipe_id, recipe_name, status, pump_commands, price, ingredients_snapshot)
               VALUES (?, ?, 'pending', ?, ?, ?)""",
            (
                recipe_id, 
                recipe_name, 
                json.dumps(pump_commands), 
                price, 
                json.dumps(ingredients_snapshot) if ingredients_snapshot else None
            )
        )
        return cursor.lastrowid


def update_order_status(order_id: int, status: str):
    """Update order status."""
    completed_at = None
    if status in ("done", "aborted", "error"):
        completed_at = datetime.now().isoformat()
    with get_connection() as conn:
        conn.execute(
            "UPDATE orders SET status = ?, completed_at = ? WHERE id = ?",
            (status, completed_at, order_id)
        )


def get_recent_orders(limit=20):
    with get_connection() as conn:
        rows = conn.execute(
            "SELECT * FROM orders ORDER BY ordered_at DESC LIMIT ?", (limit,)
        ).fetchall()
    return [dict(r) for r in rows]


def get_order_by_id(order_id: int):
    with get_connection() as conn:
        row = conn.execute("SELECT * FROM orders WHERE id = ?", (order_id,)).fetchone()
    return dict(row) if row else None


# ─────────────────────────────────────────────
#  SETTINGS
# ─────────────────────────────────────────────

def get_setting(key: str, default=None):
    """Get a configuration value from the settings table."""
    with get_connection() as conn:
        row = conn.execute("SELECT value FROM settings WHERE key = ?", (key,)).fetchone()
        if row:
            try:
                return json.loads(row["value"])
            except json.JSONDecodeError:
                return row["value"]
        return default


def set_setting(key: str, value):
    """Set a configuration value in the settings table."""
    with get_connection() as conn:
        conn.execute(
            "INSERT INTO settings (key, value) VALUES (?, ?) ON CONFLICT(key) DO UPDATE SET value = excluded.value",
            (key, json.dumps(value))
        )


# ─────────────────────────────────────────────
#  EVENTS
# ─────────────────────────────────────────────

def log_event(event_type: str, detail: str = None):
    """Log a structured machine event."""
    with get_connection() as conn:
        conn.execute(
            "INSERT INTO events (event_type, detail) VALUES (?, ?)",
            (event_type, detail)
        )


def get_recent_events(limit=50):
    with get_connection() as conn:
        rows = conn.execute(
            "SELECT * FROM events ORDER BY timestamp DESC LIMIT ?", (limit,)
        ).fetchall()
    return [dict(r) for r in rows]


# ─────────────────────────────────────────────
#  ENTRY POINT
# ─────────────────────────────────────────────

if __name__ == "__main__":
    init_db()
    print("\n[DB] Recipes:")
    for r in get_all_recipes():
        ings = ", ".join(f"{i['name']} {i['amount_ml']}ml" for i in r["ingredients"])
        print(f"  {r['name']} → {ings}")
    print("\n[DB] Pumps:")
    for p in get_all_pumps():
        print(f"  Pump {p['pump_number']}: {p['ingredient_name'] or '(empty)'} @ {p['flow_rate_ml_per_s']} ml/s")
