Trishan0/cocktail-crafter/(commit log)

2026-04-08 Add core functionality for CocktailCraft kiosk app
    - Implement main entry point in main.py to initialize the application.
    - Create mqtt_client.py for handling MQTT communication between Raspberry Pi and ESP32-S3, including connection management, message handling, and state management.
    - Develop recipe_manager.py to manage cocktail recipes, including fetching menu, validating custom drinks, and placing orders.
    - Add initial CSS file for styling the kiosk app.
    - Implement app.js for the kiosk's front-end logic, including menu rendering, order placement, and real-time updates via Server-Sent Events (SSE).
2026-04-08 Implement initial ESP32 code for cocktail dispensing system
2026-05-19 feat: initialize ESP32 firmware, project configuration, and hardware abstraction modules for automated cocktail dispensing
2026-05-19 feat: implement ESP32 MQTT dispensing logic and kiosk frontend UI structure
2026-05-19 feat: implement core ESP32 firmware modules and dark-themed kiosk UI stylesheet
2026-05-19 feat: initialize project structure with ESP32 firmware, documentation, and frontend assets
2026-05-28 feat: implement ESP32 firmware with WiFi and MQTT integration for cocktail dispensing
2026-05-28 Add ESP32 Hall Sensor Master (MUX version) implementation
2026-05-28 Add NodeMCU motor controller implementation for ESP32
2026-07-06 Make API and SSE connections dynamic by using the current hostname. Optimize screen state transitions logic.
2026-07-06 Handle alternative keys for machine_status and improve fallback for current_order_id in _state updates.
2026-07-06 feat(serial): Implement hardware simulator mode
    * Adds `SIMULATOR_MODE` config to enable/disable hardware bypass.
    * Mocks `send_order`, `send_abort`, and `send_clean` functions.
    * Simulates hardware status and sensor updates via `_simulate_order_process`.
    * Prevents physical serial port operations when in simulator mode.
    [config.py]
2026-07-06 refactor: split HardwareController interface and extract simulator/serial logic
    - Created `hardware_controller.py` defining a base `HardwareController` interface with `SimulatorController` and `SerialController` implementations.
    - Updated `app.py` to instantiate the appropriate controller at startup based on `config.SIMULATOR_MODE`.
    - Extended `SimulatorController` to simulate the full post-order auto-clean sequence (`reversing` -> `washing` -> `mixing/shake` -> `draining` -> `resealing` -> `idle`) per PROTOCOL.md.
    - Tightened `app.py` api endpoints:
    - Gated manual clean to only allow triggers when the machine is `idle`.
    - Blocked new orders while the machine is cleaning (orders only acc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
    [app.py, hardware_controller.py]
2026-07-06 feat: add fake ESP32 serial harness and developer setup guide
    - Created `fake_esp32.py` to simulate physical ESP32 hardware via serial or TCP loopback (`socket://`), allowing cross-platform development on Windows and Linux/Pi.
    - Implemented full protocol simulation including ice dispensing, abort handling, manual cleaning, and post-drink auto-cleaning sequences with glass-removal gates.
    - Added a `--chaos` mode to inject malformed JSON, unknown status frames, and response delays to stress-test Python-side serial error handling.
    [fake_esp32.py]
2026-07-06 feat: implement state validation, DB settings, and structured event logging
    - Added `machine_state.py` defining `MachineState` enums and transition validation rules from PROTOCOL.md.
    - Wired transition checks into `hardware_controller.py` to drop illegal/unknown ESP32 state updates.
    - Updated `app.py` order flow to use the `can_accept_order` validation helper.
    - Added a `settings` key-value table to SQLite (`db.py`) to persist system configurations.
    - Refactored admin PIN endpoints to persist and read verification PINs from the database.
    - Removed the fake glass-detection toggle in `HardwareManager.tsx` since detection is automated on-device.
    - Added an `events` logging table to `db.py` to l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
2026-07-06 fix(admin): resolve ReferenceError in PumpsManager test action
    - Define `handleTest` and `testingPump` state in `PumpsManager.tsx`.
    - Update `cleanSystem` in `api.ts` to accept optional `pump` parameter for single-line testing.
    - Allow admin to trigger a manual clean of a single pump slot directly from the Pumps tab.
2026-07-06 feat(admin): Implement controller mode switching API and UI
    * Adds `/api/admin/mode` endpoints to get and set controller type.
    * Introduces `_swap_controller` for thread-safe mode changes.
    * Persists controller mode (simulator/serial) in database.
    * Improves kiosk order submission: prevents double-submit, handles errors.
    * Refactors `SimulatorController` to use `MachineState.IDLE` enum.
    * Updates `cleanSystem` API to accept optional `pump` argument.
    [app.py, hardware_controller.py]
2026-07-06 refactor(kiosk): Refine drink preparation and cleaning flow for simulating mode
    - Adjust simulated drink preparation steps, progress, and messages.
    - Implement a 6-second hold for the "done" screen in the simulator.
    - Granularize post-order auto-clean cycle with more distinct steps and waits.
    - Enforce a 5-second minimum display time for the "ready" screen in the UI.
    - Introduce a new "cleaning_done" screen to confirm auto-clean completion.
    - Differentiate UI "mixing" screen based on drink preparation vs. cleaning cycle.
2026-07-06 refactor(sensor): Use glass_state string for granular detection
    * Replaces boolean `glass_present` with string `glass_state` (e.g., "no_glass", "small_glass") across all components.
    * Eagerly updates machine status to "waiting_glass" in `SerialController` after sending an order.
    * Sets `SIMULATOR_MODE` to `False` in `config.py`.
    [app.py, config.py, fake_esp32.py, hardware_controller.py, machine_state.py]
2026-07-07 feat(dev): Add API to simulate hardware messages for dev panel
    - Introduces `/api/dev/simulate-message` to allow manual triggering of STATUS or SENSOR events, including a shortcut to simulate 'dispensing' after a glass is placed.
    - Optimizes `send_order` payload to send only active pumps as a sparse array and an integer for ice, reducing data sent to the ESP32.
    - Simplifies `send_clean` command to a single `CLEAN` message for the ESP32, with Pi-side logic handling trigger/mode distinctions.
    - Enhances `send_order` eager state update by including `order_id` for better tracking of the pending order.
    [app.py, hardware_controller.py]
2026-07-07 refactor(order-execution): Skip initial 'waiting_glass' status update
    * Removed explicit 'waiting_glass' status and wait in simulator.
    * Changed initial 'machine_status' to 'dispensing' for serial control.
    * Updated associated message and progress for immediate UI transition.
    [hardware_controller.py]
2026-07-07 feat(hardware, kiosk): Refine order flow, enhance clean, add dev bypass
    * Refine the order process by explicitly handling "waiting_glass" state in `SimulatorController` and `SerialController`, and adjusting `SerialController.send_order` payload/eager status.
    * Enhance `SerialController.send_clean` to support detailed triggers (`post_order`, `manual`) and specific pump information.
    * Add a Kiosk UI development shortcut to bypass the glass sensor for testing.
    [hardware_controller.py]
2026-07-07 refactor(serial): Optimize order payload for hardware controller
    - Filter pump commands to include only active pumps with duration.
    - Reduce pump command data to only pump index and duration_ms.
    - Remove recipe_name from payload sent to hardware.
    - Convert ice boolean to integer 1 or 0.
2026-07-08 feat(order): Add explicit glass confirmation API and UI
    * Introduces `/api/order/confirm-glass` to allow operators to confirm glass placement, transitioning the machine from `waiting_glass` to `dispensing`.
    * Implements `send_glass_ok` in both simulator and serial hardware controllers.
    * Updates the `WaitingGlass` UI to use the new API endpoint for its bypass button, removing the previous dev shortcut.
    [app.py, hardware_controller.py]
2026-07-08 feat(sensors): Propagate and display individual glass sensor states
    - Add `lower_sensor` and `upper_sensor` to internal state, API, and SSE events.
    - Display individual sensor states on the "Waiting for Glass" UI.
    - Introduce `required_glass` to serial `ORDER` command based on recipe volume.
    - Prevent duplicate callback registrations in hardware controller.
    - Allow `WAITING_GLASS` state to self-loop for robust state updates.
    - Rename `/admin/simulator` endpoint to `/admin/mode`.
    [app.py, hardware_controller.py, machine_state.py]
2026-07-08 feat(machine): Implement soft power management and pump timing
    * Introduce admin-controlled soft power state for the machine.
    * Prevent orders when machine is powered off and trigger reverse rinse on shutdown.
    * Add `initial_extra_ms` (startup prime) and `reverse_ms` (shutdown rinse) settings for individual pumps.
    * Expose new admin API endpoints for power control and pump timing updates.
    * Track and communicate `first_order_after_power_on` status.
    [app.py, db.py, hardware_controller.py, recipe_manager.py]
2026-07-08 refactor(cleaning): Post-order clean waits for glass removal; power-off omits rinse
    * Post-order cleaning sequence now initiates only after glass removal.
    * Power-off sequence now only reverses pump lines, omitting the rinse cycle.
    * Updated simulator logic, state transitions, and UI messages to reflect new flow.
    [app.py, hardware_controller.py, machine_state.py]
2026-07-08 feat: implement ESP32 controller
2026-07-09 Manual Control For ICE Stepper
2026-07-09 Manul Pump controlling codes
2026-07-19 Testing Level Sensors
2026-07-19 Calibrating N20 motor codes
2026-07-21 feat: update firmware architecture with state-driven hardware control and status LEDs
2026-07-27 refactor: remove pump timing configuration from Pi and delegate to ESP32 firmware
2026-07-27 refactor: remove `serial_client.py` and migrate serial communication responsibilities to ESP32
2026-07-27 feat: implement automatic glass detection and start order based on IR sensors
2026-07-27 feat: add liquid-level sensor support and UI for real-time monitoring
2026-07-27 feat: add pump inventory tracking and validation features
2026-07-29 refactor: simplify pump management and remove per-pump sensor baseline calibration
2026-07-31 Manual motor control update
2026-07-31 feat: add ESP32 diagnostic interface with admin commands and detailed logging
2026-07-31 Moving Prototype Files
2026-07-31 feat: improve hardware readiness handling and UI feedback
    - Update firmware connection and readiness management across backend and frontend.
    - Enhance `AdminDashboard` UI to reflect hardware connection and firmware readiness states.
    - Add detailed error handling for ESP32 communication and command processing.
    - Introduce new firmware status checks and update serial handling logic.
    - Adjust DEFAULT_FLOW_RATE from 1.5 to 2.5 ml/s.
    [app.py, config.py, fake_esp32.py, hardware_controller.py]
2026-08-01 feat: implement small glass capacity calibration and validation safety
    - Add admin-configurable `small_glass_max_ml` setting with default of 170 ml.
    - Validate glass capacity against recipe volume before starting a drink.
    - Enhance frontend with glass capacity management UI in `HardwareManager`.
    - Update backend to enforce glass capacity interlock, including volume checks and feedback.
    - Extend Raspberry Pi and ESP32 interaction logic for glass size and safety policies.
2026-08-01 feat: implement liquid reserve margin for order safety and update inventory logic
    - Add `LIQUID_RESERVE_MARGIN_ML` (15 ml) to backend configuration for safety.
    - Modify order process to enforce safety reserve during volume checks and atomic deductions.
    - Enhance pump inventory logic to track orderable volume excluding reserve.
    - Update admin UI to reflect bottle reserves and available volumes for orders.
    - Add real-time inventory updates via SSE to sync frontend with backend changes.
    - Refactor custom mix and drink availability checks for reserve compliance in frontend.
2026-08-01 feat: implement final `drink/ready` event and update post-drink cleaning flow
    - Add `drink/ready` event to mark order completion for the customer-facing UI.
    - Update Raspberry Pi firmware logic to handle glass removal and cleaning phase post-drink.
    - Refactor backend order flow to distinguish between order completion and cleaning state.
    - Enhance state transitions in `machine_state.py`, backend tests, and frontend screen syncing.
    - Improve post-drink CHECK_IR polling for glass removal before cleaning initiation.
    - Update documentation to reflect the new event and process changes.
2026-08-01 feat: preserve historical order data when deleting recipes
    - Update database schema to use `ON DELETE SET NULL` for `orders.recipe_id` to retain order snapshots.
    - Modify `delete_recipe` function to null `recipe_id` before deletion for compatibility with existing databases.
    - Enhance API to return 404 error if trying to delete a non-existent recipe.
    [app.py, db.py]
2026-08-01 chore: group prototypes and calibration material
2026-08-02 chore: retain Pump 6 reference and ignore legacy handoff docs
2026-08-02 update: Increase pump cleaning and post valve delay times
2026-08-02 Update pump controller references to NodeMCU-32S
2026-11-03 feat: add local simulator for UI testing and enhance DevPanel functionality
    - Introduced `dev_sim.py` for running the backend with a SimulatorController, allowing local UI testing without hardware.
    - Updated `DEV_SETUP.md` with instructions for using the simulator.
    - Enhanced `SimulatorController` to handle glass events and reset state for simulated orders.
    - Modified `api_dev_simulate_message` to support simulator-specific behavior.
    - Updated `DevPanel` to provide buttons for simulating hardware messages and controlling the simulator.
    - Adjusted API calls in `api.ts` to resolve the base URL dynamically.
    - Updated frontend dependencies and configurations for improved compatibility.
2026-11-04 Refactor admin UI styles and update backdrop images
    - Removed sepia filter from machine image in kiosk.css.
    - Updated admin.tsx to use a new machine backdrop for the admin panel.
    - Changed the default ordered drink name to a constant for clarity.
    - Replaced HOUSE_BACKDROP with MACHINE_BACKDROP in multiple screens for consistency.
    - Enhanced admin dashboard styles for improved readability and aesthetics, including color updates and layout adjustments.
    - Adjusted responsive styles for better usability on smaller screens.
2026-11-05 Implement real-time drink progress tracking and UI updates
    - Add OrderProgress class to manage drink preparation steps based on firmware events.
    - Create unit tests for OrderProgress to validate event handling and state transitions.
    - Update fake ESP32 simulation to reflect accurate timing for pump operations.
    - Revamp kiosk CSS for improved visual representation of drink preparation phases.
    - Modify KioskApp to utilize order progress data from the backend, enhancing user feedback during drink preparation.
